jytole/train-and-go/website/images/chair_trip.jpg

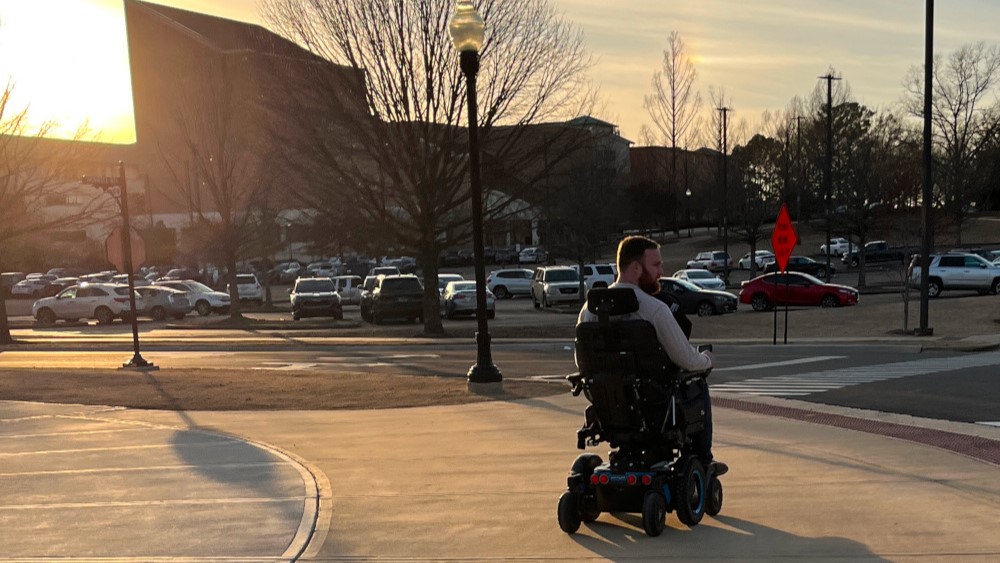
website/images/chair_trip.jpg
