jytole/train-and-go/website/images/brake_lights.jpg

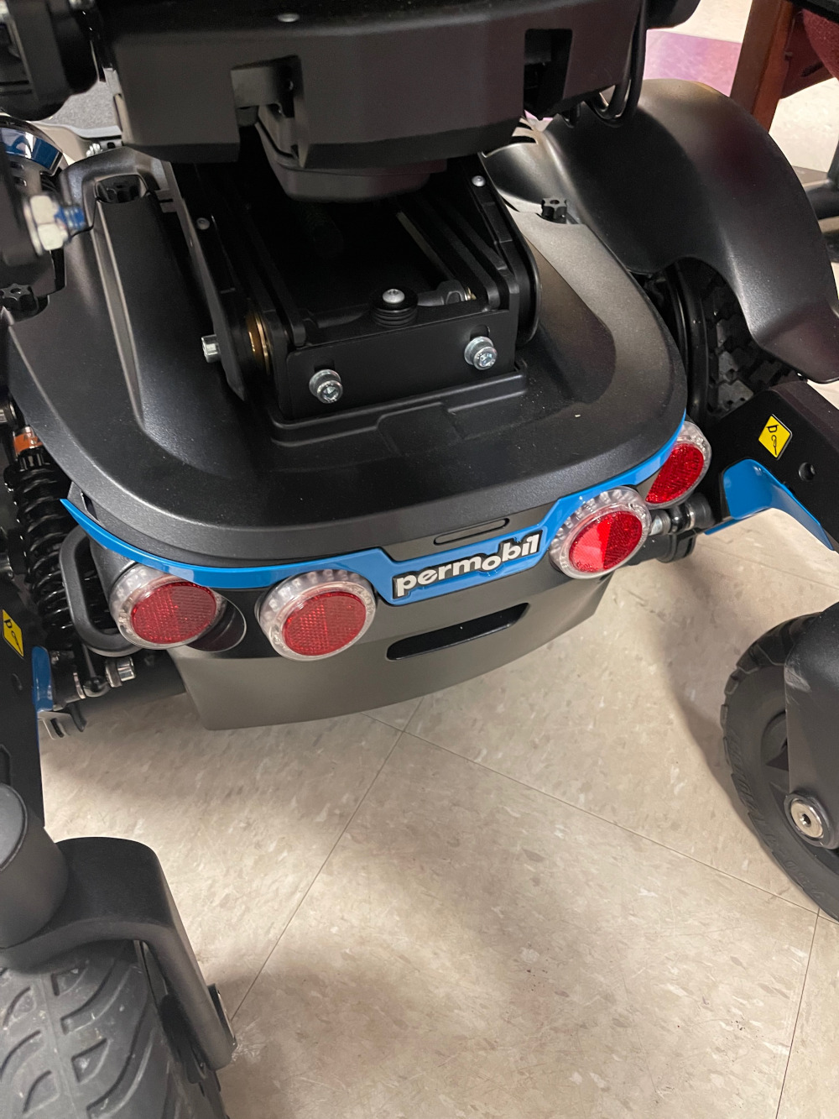
website/images/brake_lights.jpg
