jytole/train-and-go/website/deliverables/TrainandGo_Final_Presentation.pdf

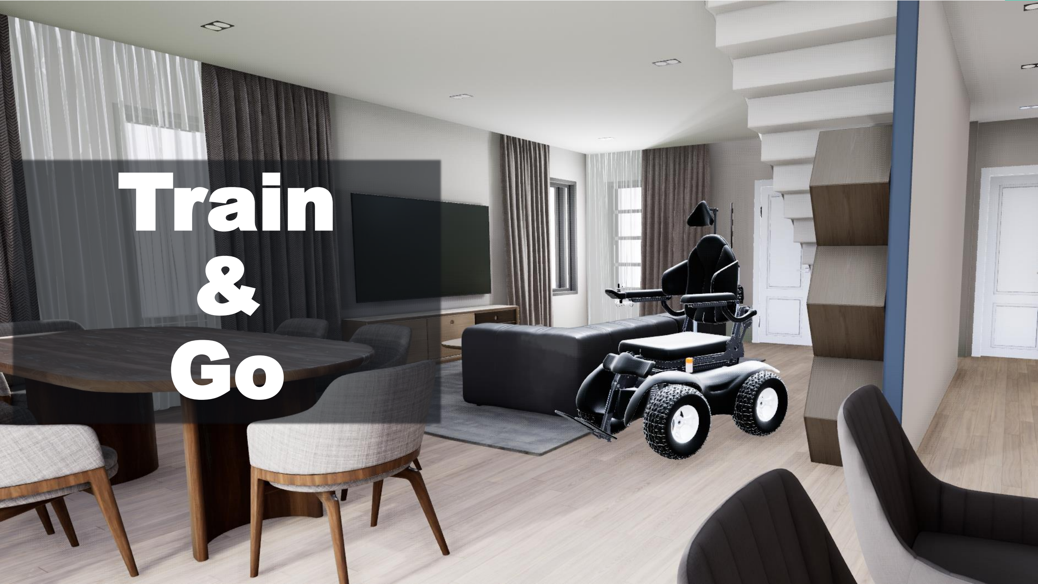
[picture p85: page 1]

# Train

&
Go

# TEAM MEMBERS

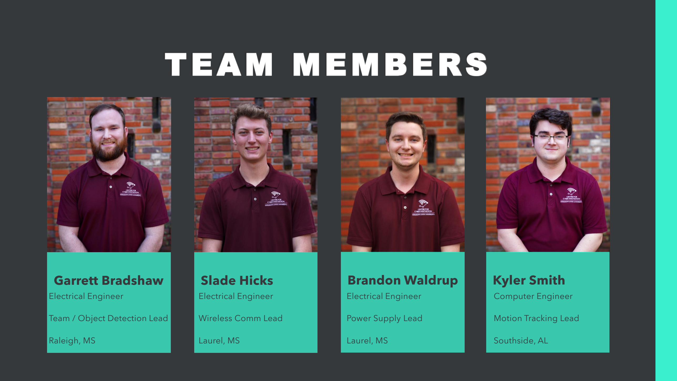
[picture p86: page 2]

## Garrett Bradshaw

Electrical Engineer

Team / Object Detection Lead

Raleigh, MS

## Slade Hicks

Electrical Engineer

Wireless Comm Lead

Laurel, MS

## Brandon Waldrup

Electrical Engineer

Power Supply Lead

Laurel, MS

## Kyler Smith

Computer Engineer

Motion Tracking Lead

Southside, AL

# INTERNAL ADVISOR

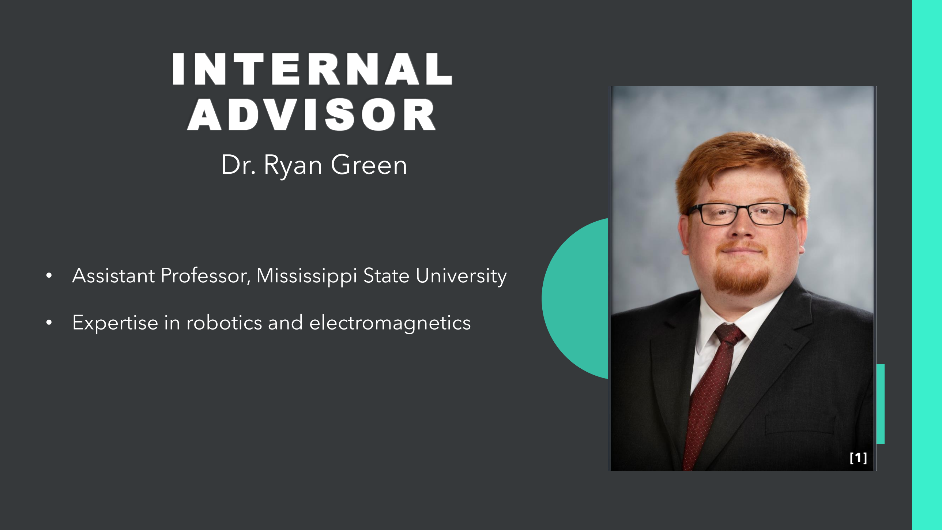
[picture p87: page 3]

# - Assistant Professor, Mississippi State University

# - Expertise in robotics and electromagnetics

# Dr. Ryan Green

[1]

# EXTERNAL ADVISOR

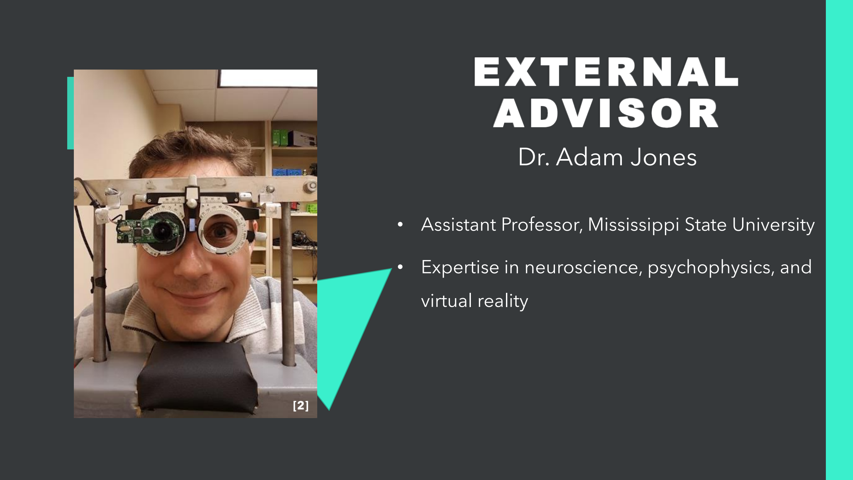
[picture p88: page 4]

# - Assistant Professor, Mississippi State University

# - Expertise in neuroscience, psychophysics, and

# virtual reality

# Dr. Adam Jones

[2]

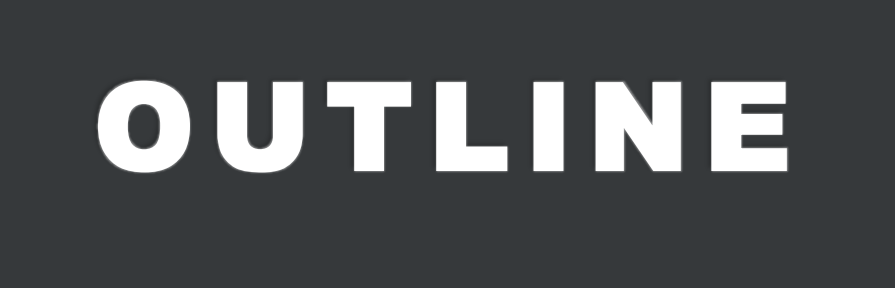
[picture p89: figure]
OUTLINE
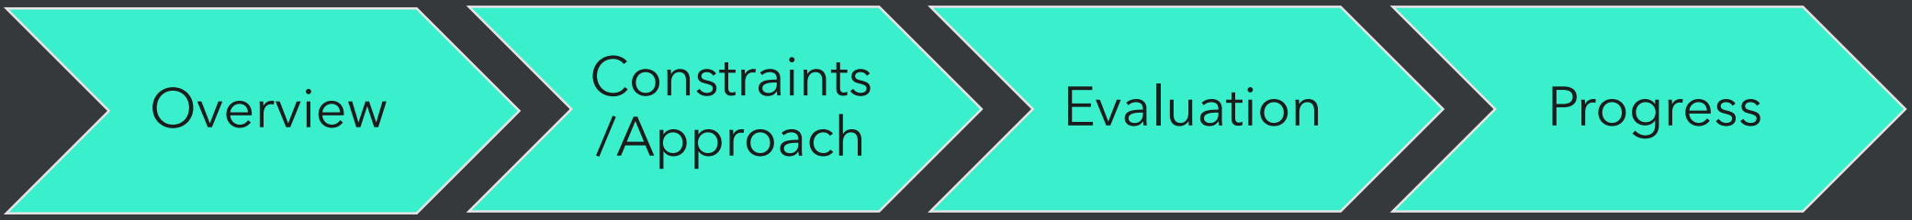
[picture p90: figure]
Overview; Constraints; /Approach; Evaluation; Progress
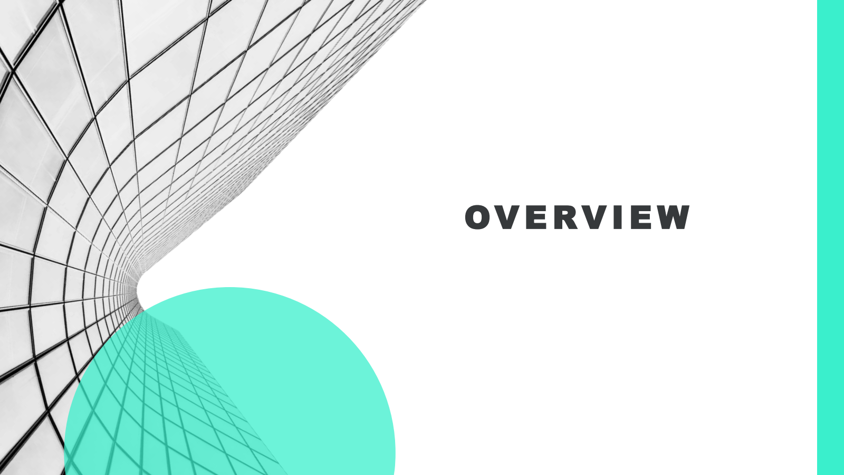
[picture p91: page 6]

# OVE RVI E W

# Problem

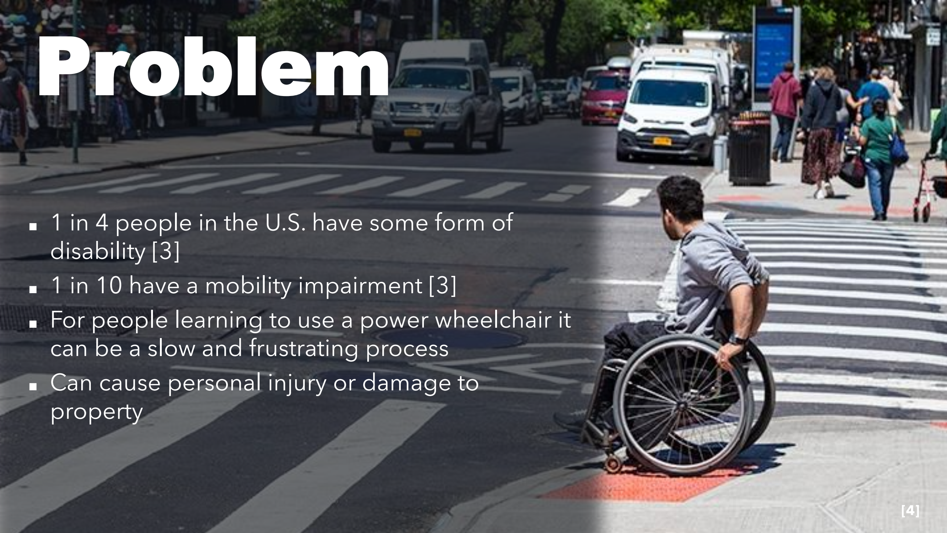
[picture p92: page 7]

[4]

# ∎ 1 in 4 people in the U.S. have some form of disability [3] ∎ 1 in 10 have a mobility impairment [3] ∎ For people learning to use a power wheelchair it can be a slow and frustrating process ∎ Can cause personal injury or damage to property

# Solution

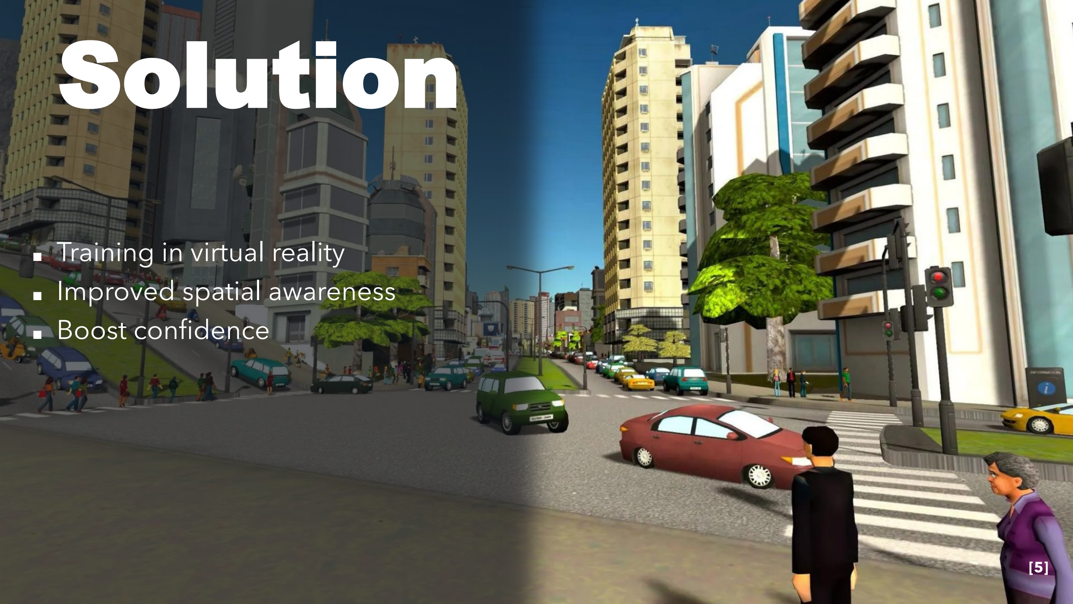
[picture p93: page 8]

8

# ∎ Training in virtual reality ∎ Improved spatial awareness ∎ Boost confidence

[5]

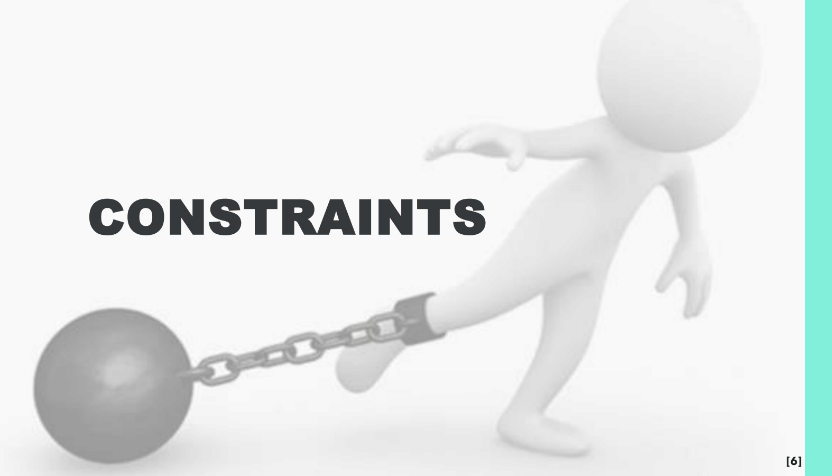
[picture p94: page 9]

# CONSTRAINTS

[6]

# TECHNICAL CONSTRAINTS

Name | Description
Wheelchair Speed | The system is attached to a wheelchair moving no faster than five miles per hour [7].
Detection Distance | The system detects objects within a radius of no more than 2.2 meters.
Feedback Latency | This system’s latency for sending feedback to the user in response to an object is no more than 250 milliseconds.
Sensor Accuracy | The system’s false detection rate is less than 16 percent.
Wireless Range | The system can connect wirelessly to a Quest VR headset within 2.31 meters.
Wireless Latency | The wireless latency is less than 250 milliseconds.

# PRACTICAL CONSTRAINTS

Type | Name | Description
Sustainability | Reliability | Train and Go is designed to operate for at least five years without component failure.
Sustainability | Sensor Maintenance | Sensor connections are placed strategically to allow simple maintenance or replacement.
Usability | Product Versatility | Train and Go offers a flexible packaging system to attach to a variety of wheelchair designs and does not inhibit existing chair functionality.
Safety | Collision Detection | Train and Go provides the user with feedback to minimize the risk of collisions with obstacles.
Functionality | VR Communication | Train and Go communicates with a Quest VR headset.

# ENGINEERING STANDARDS

Specific Standard | Standard Document | Specification / Application
IP-44 | International Electrotechnical Commission Standard 60529 | The system is protected from solid particles that are over 1 millimeter in size and from splashes of water [8].
Bluetooth | Institute of Electrical and Electronics Engineers 802-15.1 | The system adheres to IEEE Bluetooth standards [9].
Protection Against Electric Shock | International Electrotechnical Commission Standard 62368 | The electrical components of the system are isolated from the user to prevent electric shock [10].
Wheelchair Accessory | FDA 21 Code of Federal Regulations § 890.3910 | Train and Go satisfies the FDA standards for a wheelchair accessory [11].

# FUNCTIONAL DIAGRAM


# HARDWARE

# ASSEMBLY DIAGRAM


[12]

# HARDWARE

Part Type | Part
Ultrasonic Sensor [13] | HCSR04
Rumble Motor [14] | Tatoko
DC-DC Converter [15] | Yipin Hexha
VR Headset [16] | Meta Quest Pro
IMU [17] | ISM330DHCX
Detection Microcontroller [18] | Elegoo Mega
Orientation Microcontroller [19] | ESP32
Battery [20] | Zeee 2S Lipo
Voltage Rail [21] | Evemodel

# SOFTWARE

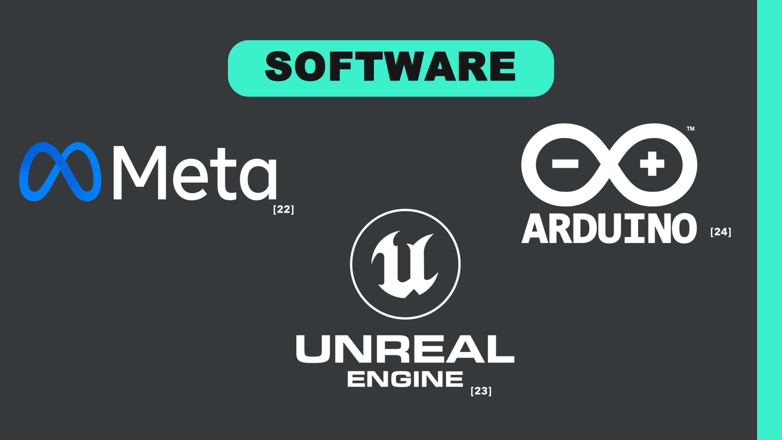
[picture p95: page 17]

[22]

[23]

[24]

# OLD ORIENTATION PROCESSING

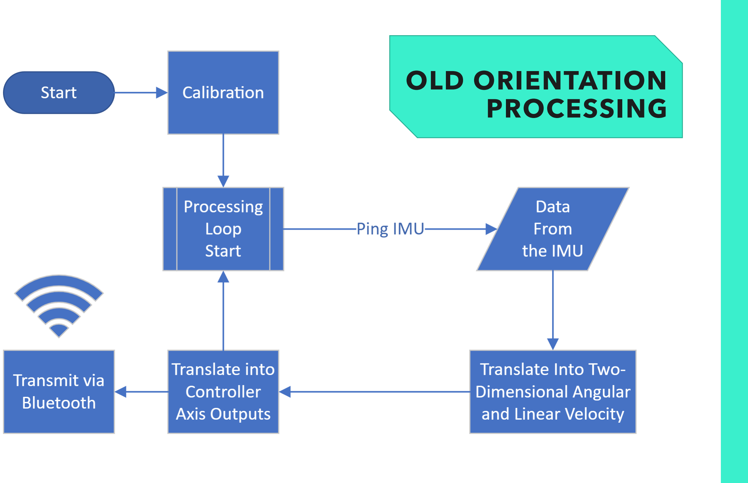
[picture p96: page 18]
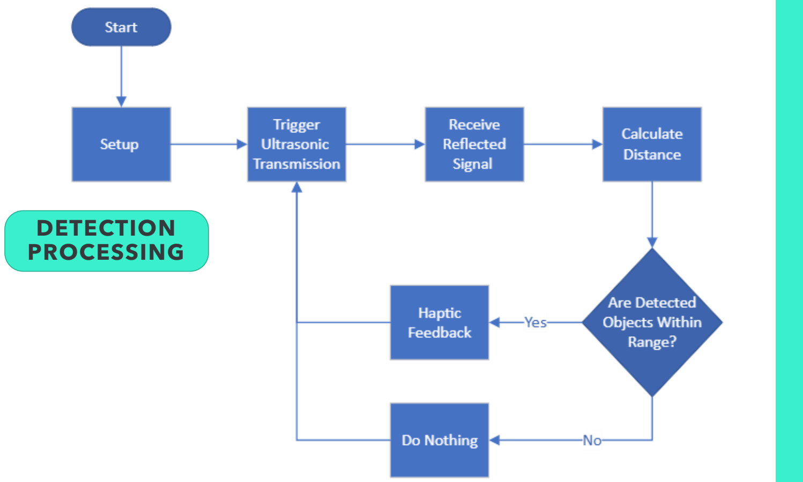
[picture p97: page 19]

# DETECTION PROCESSING

# VR ENVIRONMENT

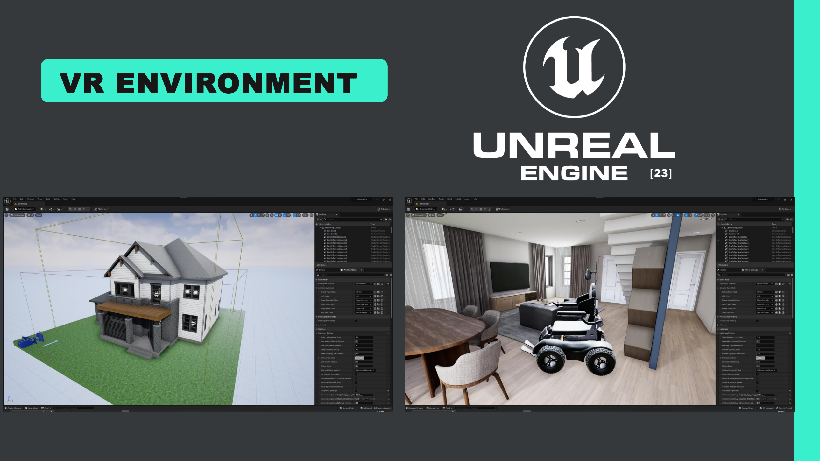
[picture p98: page 20]

[23]

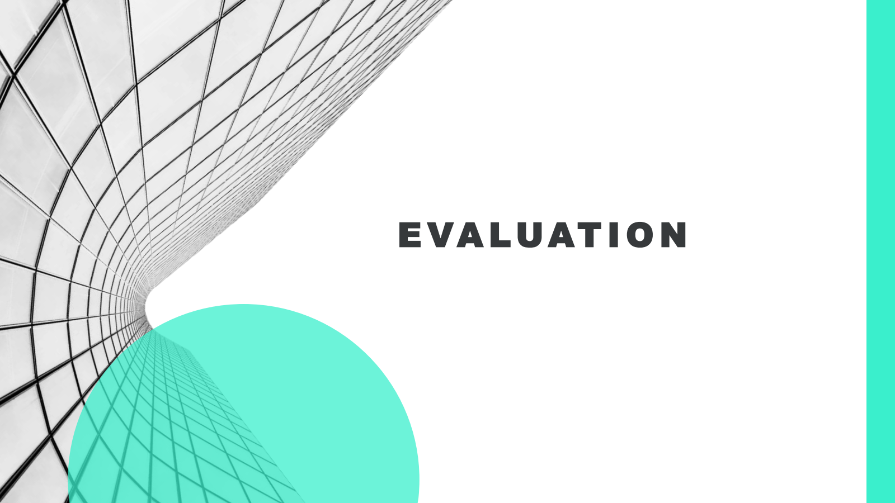
[picture p99: page 21]

# E VALUAT I ON

# BLUETOOTH CONNECTION

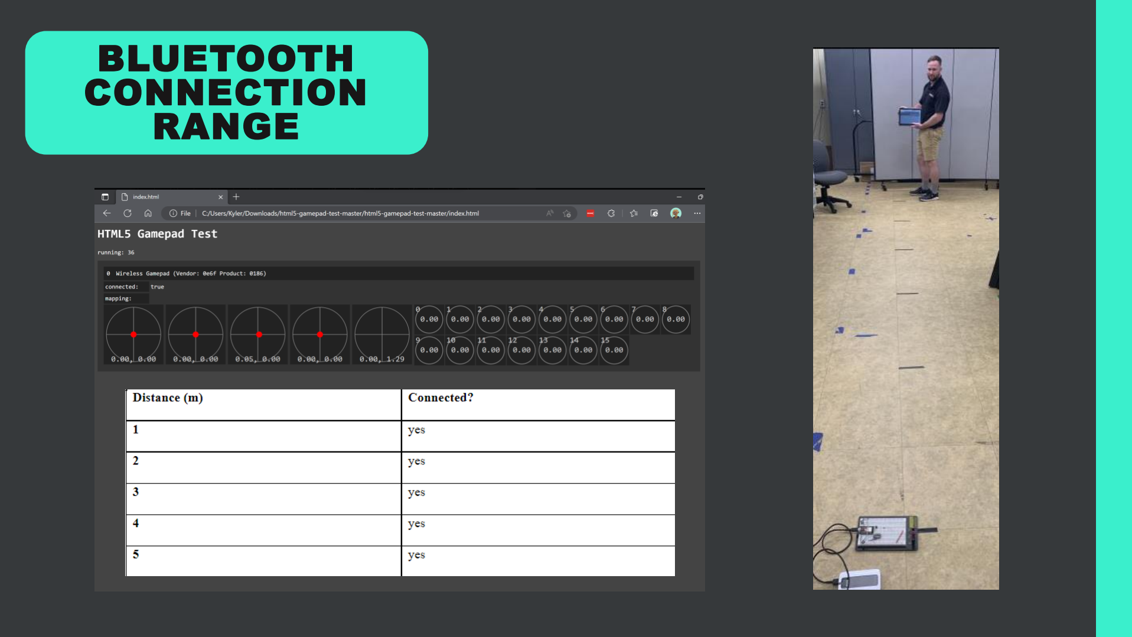
[picture p100: page 22]

# RANGE

# ULTRASONIC

# SENSOR

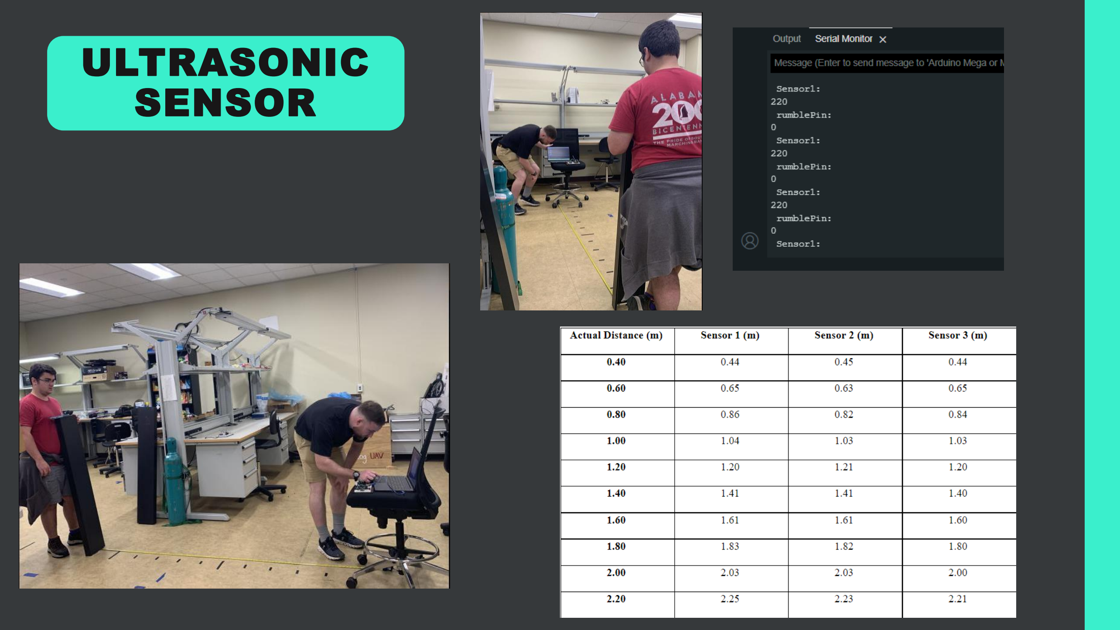
[picture p101: page 23]

# SENSOR

# ACCURACY AND

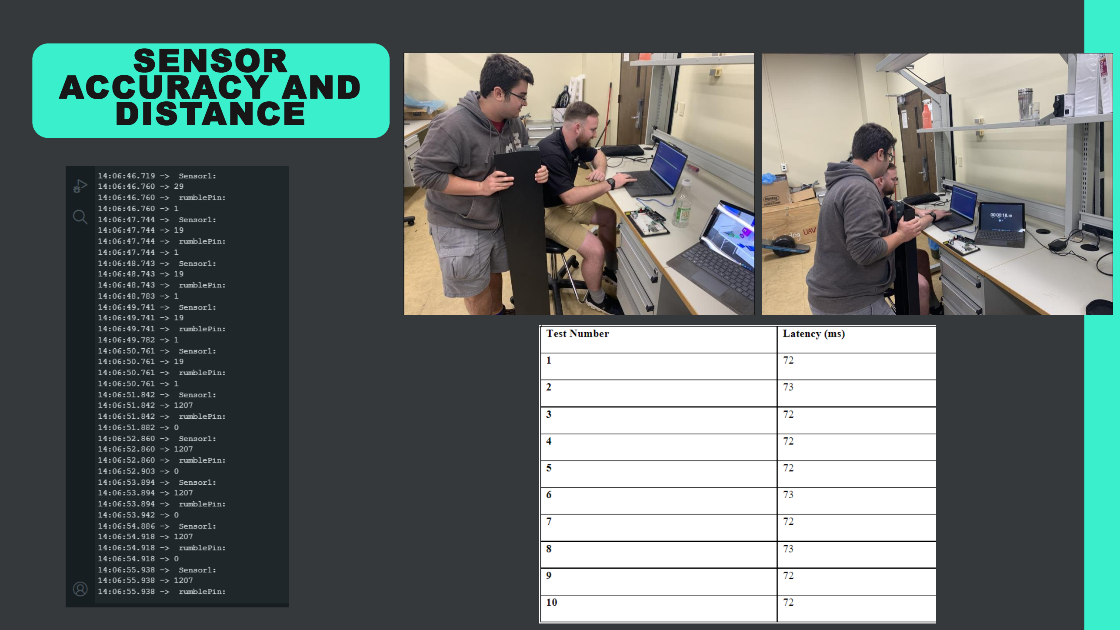
[picture p102: page 24]

# DISTANCE

# IP44 WATER RESISTANCE TEST

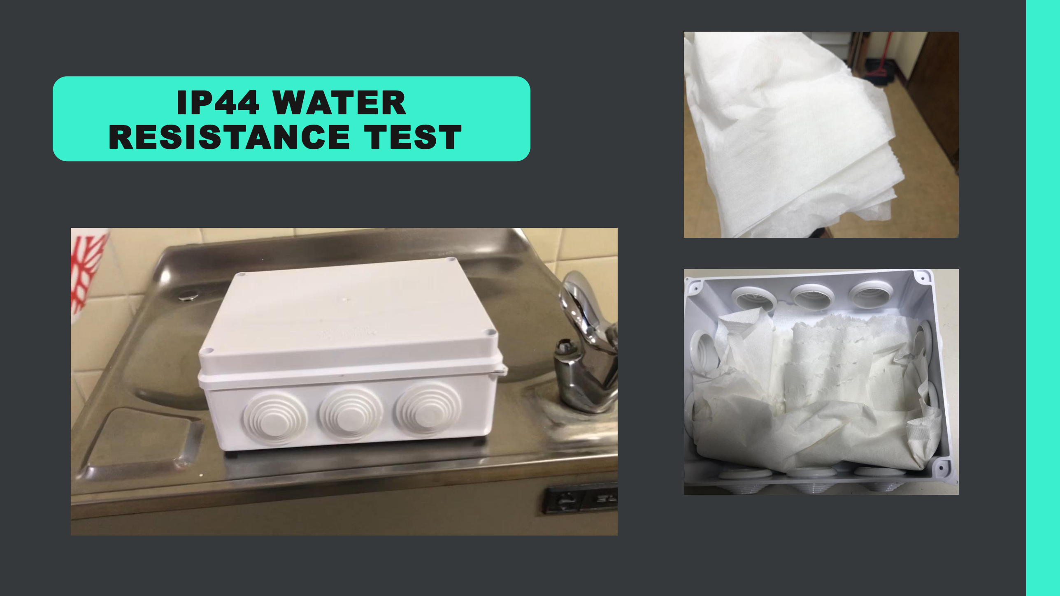
[picture p103: page 25]

# IMU ACCURACY

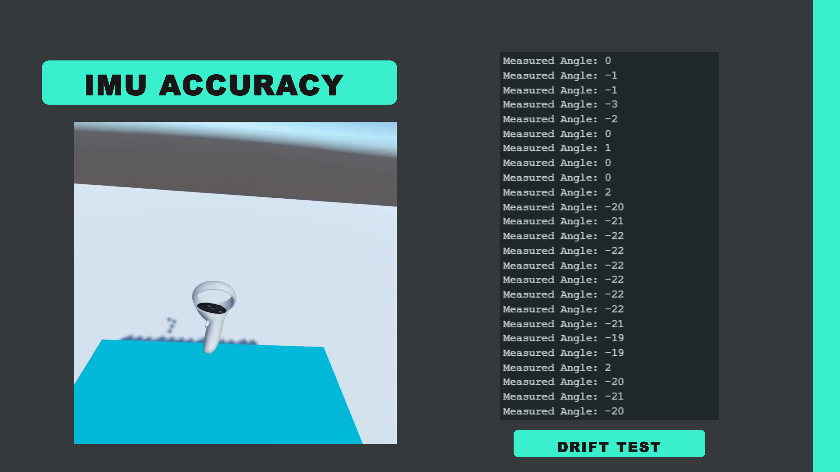
[picture p104: page 26]

### DRIFT TEST

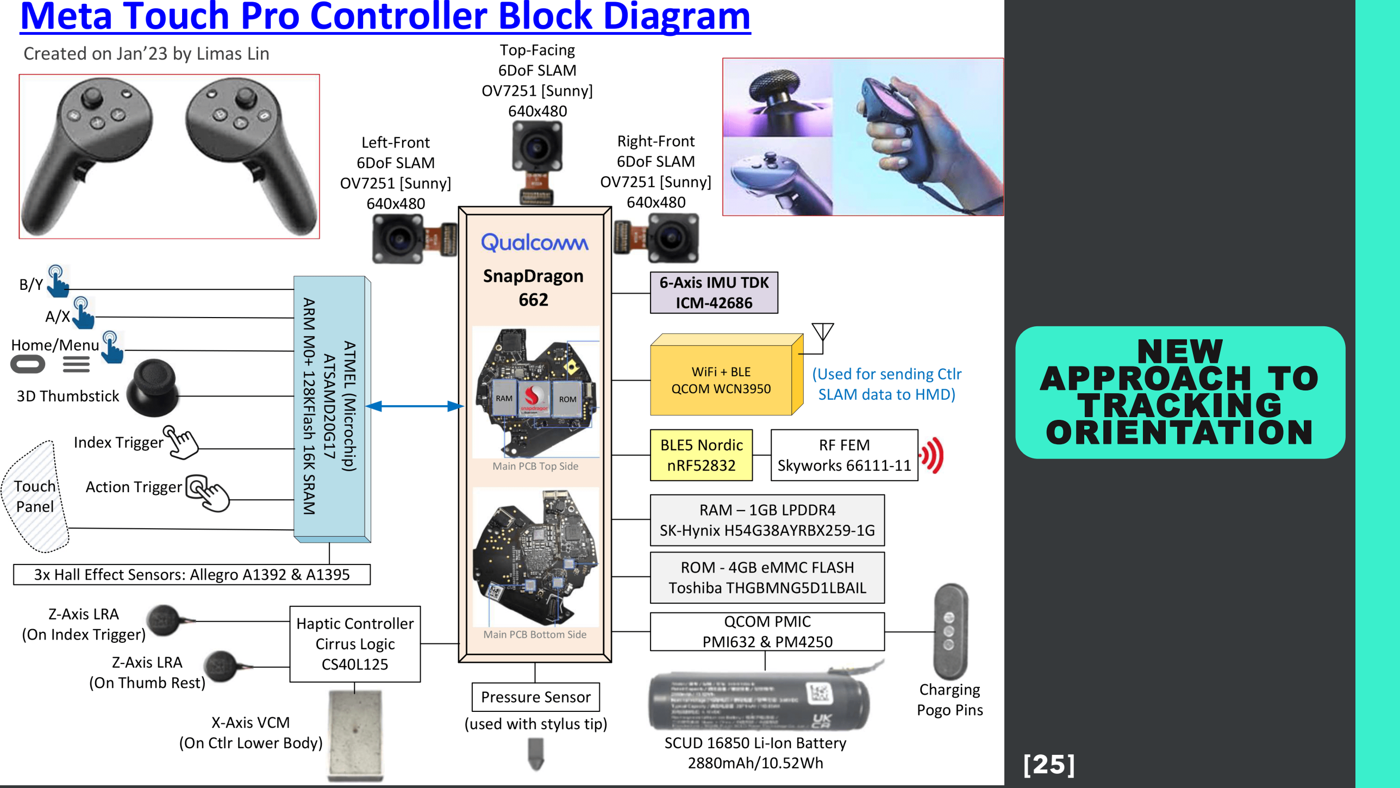
[picture p105: page 27]

# NEW APPROACH TO TRACKING ORIENTATION

[25]

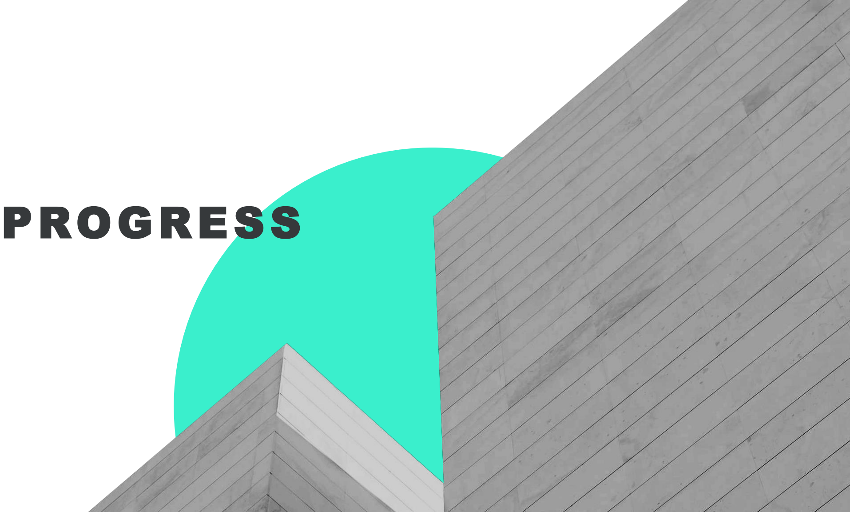
[picture p106: page 28]

# PROGRESS

# TIMELINE

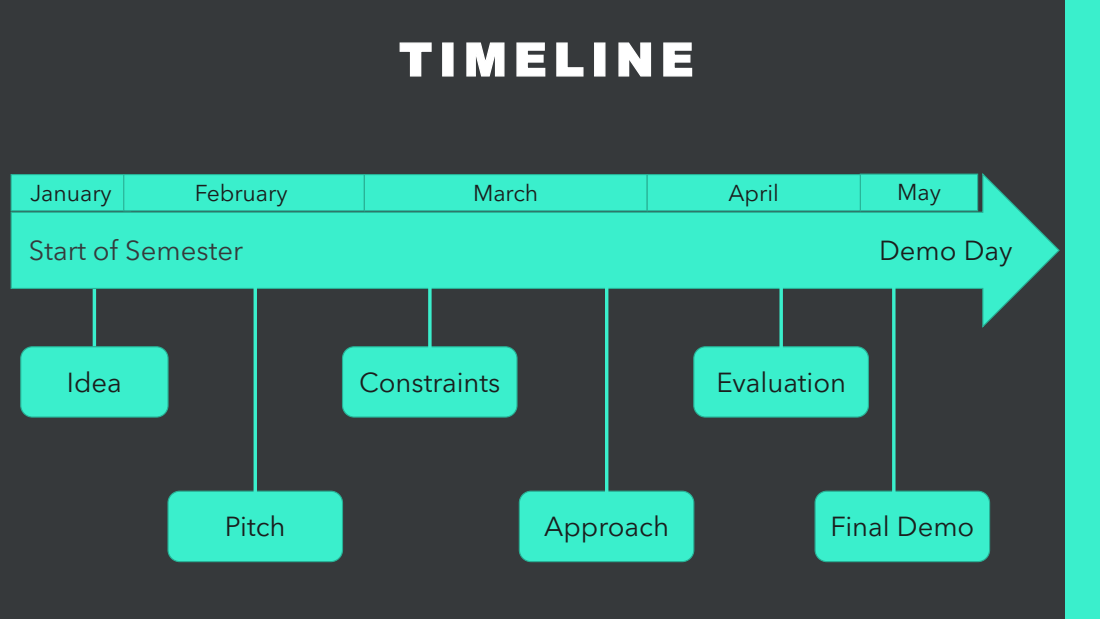
[picture p107: page 29]
Start of Semester; Demo Day; Idea; Pitch; Constraints; Approach; Evaluation; Final Demo; January; February; March; April; May

# ASSEMBLY

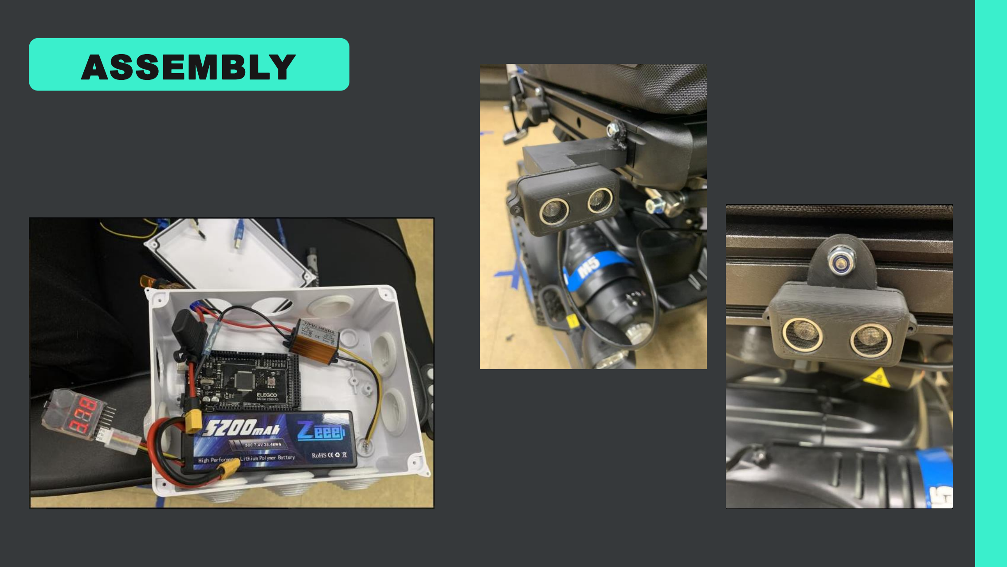
[picture p108: page 30]

# VR ENVIRONMENT

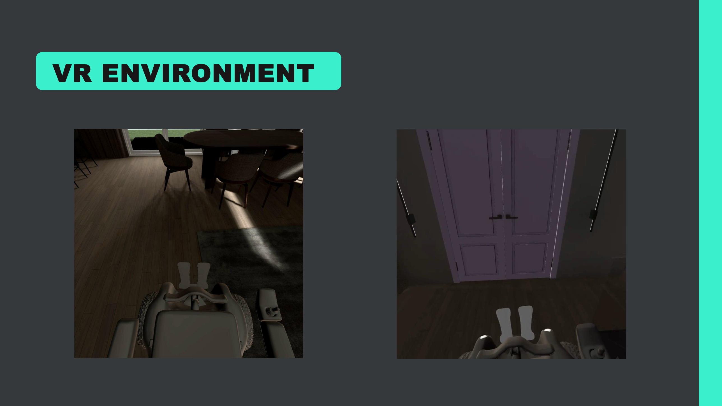
[picture p109: page 31]

# VR ENVIRONMENT

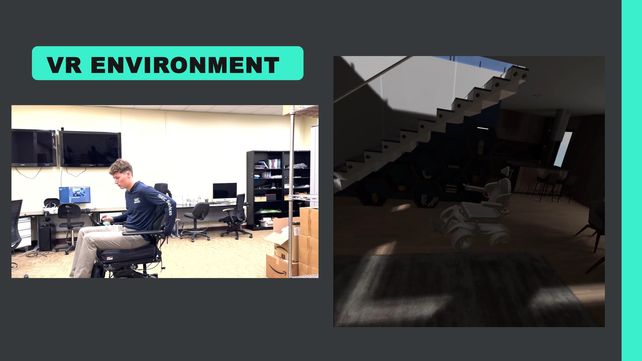
[picture p110: page 32]

# What is left :

# - Finish testing any remaining subsystems checks

# - Finalize construction of the prototype for demo day

# Future improvements:

# - Develop a PCB for sensor connections inside the enclosure

# - Curate additional VR environments

# - Optimize obstacle detection and haptic feedback to be directional

# FINAL TO DO LIST AND IMPROVEMENTS FOR REVISION: 02

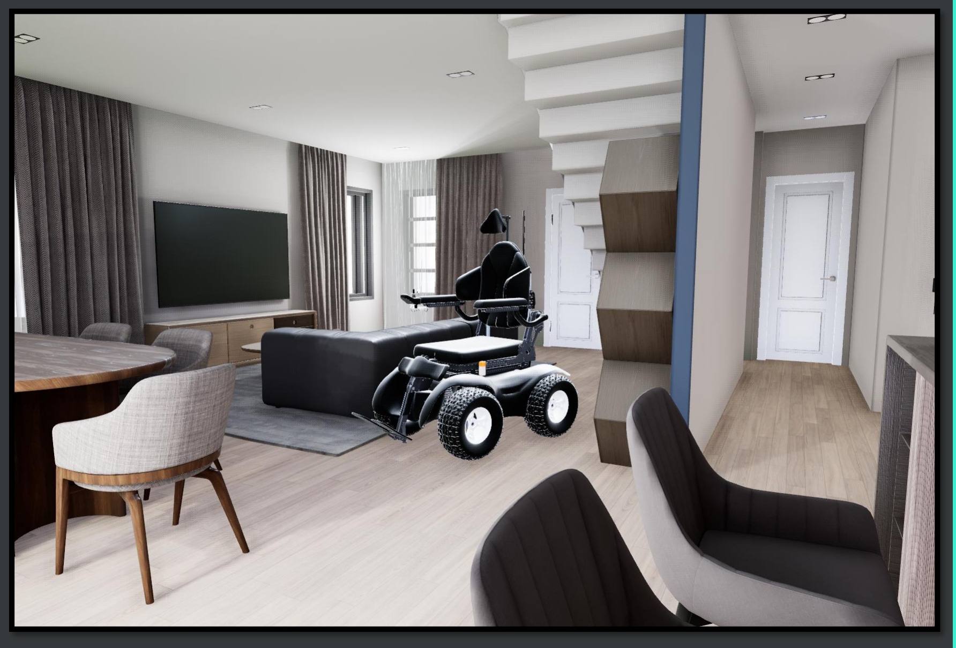
[picture p111: figure]

# - Train and Go provides an

# enhanced VR wheelchair training

# experience

# - Train and Go ensures user safety

# during that training experience

# - Train and Go empowers people

# with disabilities

# CONCLUSION

# S O U R C E S

[1] Mississippi State University, "Faculty," msstate.edu. https://www.ece.msstate.edu/people/faculty/ (Accessed: Mar. 25, 2023).
[2] Mississippi State University, "Faculty," msstate.edu. https://www.cse.msstate.edu/people/faculty/ (Accessed: Mar. 25, 2023).
[3] Centers for Disease Control and Prevention, "Disability impacts all of us," Cdc.gov. https://www.cdc.gov/ncbddd/disabilityandhealth/infographicdisability-impacts-all.html (Accessed: Jan. 31, 2023).
[4] United Spinal Association, "NYC sidewalks finally complying with ADA," unitedspinal.org. https://unitedspinal.org/nyc-sidewalks-finally-complyingwith-ada/ (Accessed Jan. 31, 2023).
[5] L. Faria, "Review-cities VR," waytoomany.games. https://waytoomany.games/?s=cities+vr (Accessed: Jan. 31, 2023).
[6] Disher, "Product constraints: The catalyst of great design," disher.com. https://www.disher.com/blog/product-constraints-can-catalyst-greatdesign/ (Accessed: Mar. 25, 2023).
[7] A. Smith, “How fast do electric wheelchairs go?” Mobility Medical Supply. https://mobilitymedicalsupply.com/how-fast-do-electric-wheelchairs-go/. (Accessed: Feb. 16, 2023).
[8] Degrees of protection provided by enclosures (IP Code), International Electrotechnical Commission 60529, International Electrotechnical Commission, 2019. https://www.iec.ch/ip-ratings. (Accessed: Feb. 22, 2023).
[9] Medium access control and physical layers, Institute of Electrical and Electronics Engineers 802.15.1, Institute of Electrical and Electronics Engineers, 2005. https://standards.ieee.org/ieee/802.15.1/3513/. (Accessed: Feb. 22, 2023).
[10] Audio/video, information, and communication technology equipment - Part 1: Safety requirements, International Electrotechnical Commission 62368, International Electrotechnical Commission, 2018. https://webstore.iec.ch/publication/63964. (Accessed: Feb. 22, 2023).
[11] Wheelchair accessory, Code of Federal Regulations Title 21 Section 890.3910, FDA, 2001. https://www.accessdata.fda.gov/scripts/cdrh/cfdocs/cfcfr/cfrsearch.cfm?fr=890.3910. (Accessed: Feb. 22, 2023).
[12] "Permobil M5 corpus power wheelchair," medicaleshop.com. https://www.medicaleshop.com/permobil-m5-corpus-power-wheelchair.html (Accessed: Mar. 25, 2023).
[13] “HC-SR04 Ultrasonic Distance Sensor,” amazon.com. https://www.amazon.com/ACEIRMC-HC-SR04-Ultrasonic-Distance-ElecRightt/dp/B09J4BN46F/r (Accessed: Mar. 03, 2023).

# S O U R C E S

[14] “Tatoko Rumble Motor,” amazon.com. https://www.amazon.com/tatoko-vibration-Waterproof-8000-16000RPM-toothbrush/dp/B07KYLZC1S/(Accessed: Mar. 03, 2023).
[15] “YIPIN HEXHA Voltage Converter,” amazon.com. https://www.amazon.com/dp/B0BS5ZCP1N (Accessed: Mar. 03, 2023 ).
[16] “Meta Quest Pro,” amazon.com. https://www.amazon.com/Meta-Quest-Pro-Oculus/dp/B09Z7KGTVW/ (Accessed: Mar. 03, 2023).
[17] “Adafruit ISM330DHCX – 6 DoF IMU,” adafruit.com. https://www.adafruit.com/product/4502 (Accessed: Mar. 03, 2023).
[18] “Elegoo Mega Microcontroller,” amazon.com. https://www.amazon.com/ELEGOO-ATmega2560-ATMEGA16U2-Arduino-Compliant/dp/B01H4ZDYCE/ (Accessed: Mar. 03, 2023).
[19] “ESP32 datasheet,” adafruit.com. https://cdn-shop.adafruit.com/product-files/3269/esp32_datasheet_en_0.pdf (Accessed: Mar. 03, 2023).
[20] “Zeee 2S Lipo Battery,” amazon.com. https://www.amazon.com/dp/B092CZGW2P (Accessed: Mar. 03, 2023).
[21] “Evemodel Power Rail,” amazon.com. https://www.amazon.com/PCB007-Position-Distribution-Outputs-Voltage/dp/B07DW2C4ZB (Accessed: Mar. 03, 2023).
[22] "File:Meta Platforms Inc. logo.svg," wikimedia.org. https://commons.wikimedia.org/wiki/File:Meta_Platforms_Inc._logo.svg (Accessed: Mar. 25, 2023).
[23] "Unreal engine branding," unrealengine.com. https://www.unrealengine.com/en-US/branding (Accessed: Mar. 25, 2023).
[24] "Arduino - home," arduino.cc. https://www.arduino.cc/ (Accessed: Mar. 25, 2023).

[25]”Meta Quest Pro Controller”, kguttag.com https://kguttag.com/2023/03/15/meta-quest-pro-part-2-block-diagrams-teardown-of-headset-andcontroller/ (Accessed: April 26, 2023)
