jytole/train-and-go/website/images/brandon_waldrup.jpg

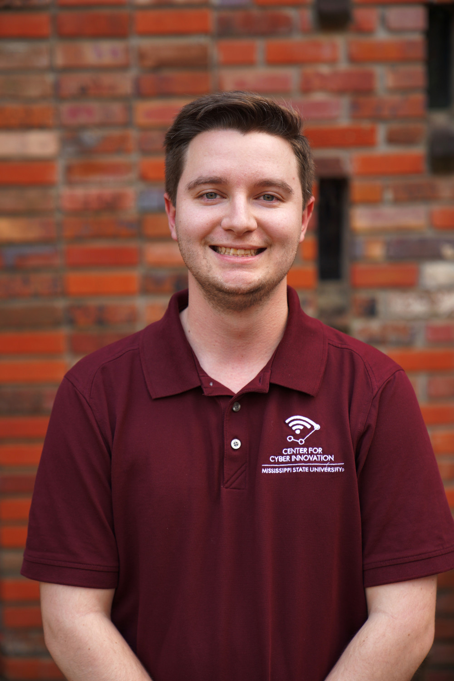
website/images/brandon_waldrup.jpg
