jytole/train-and-go/website/images/garrett_bradshaw.jpg

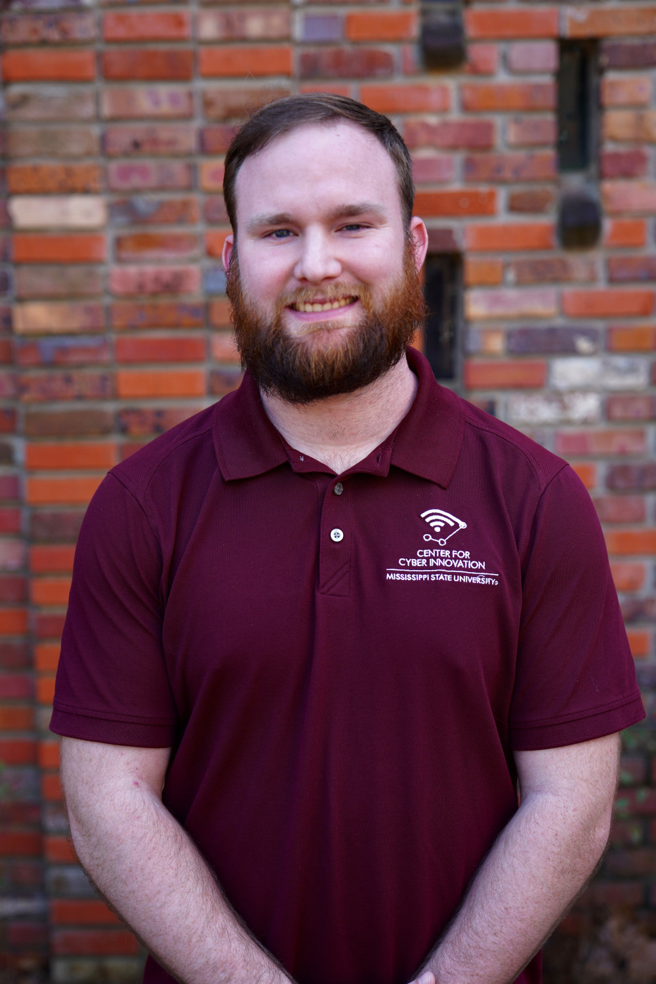
website/images/garrett_bradshaw.jpg
