jytole/train-and-go/website/images/joystick.jpg

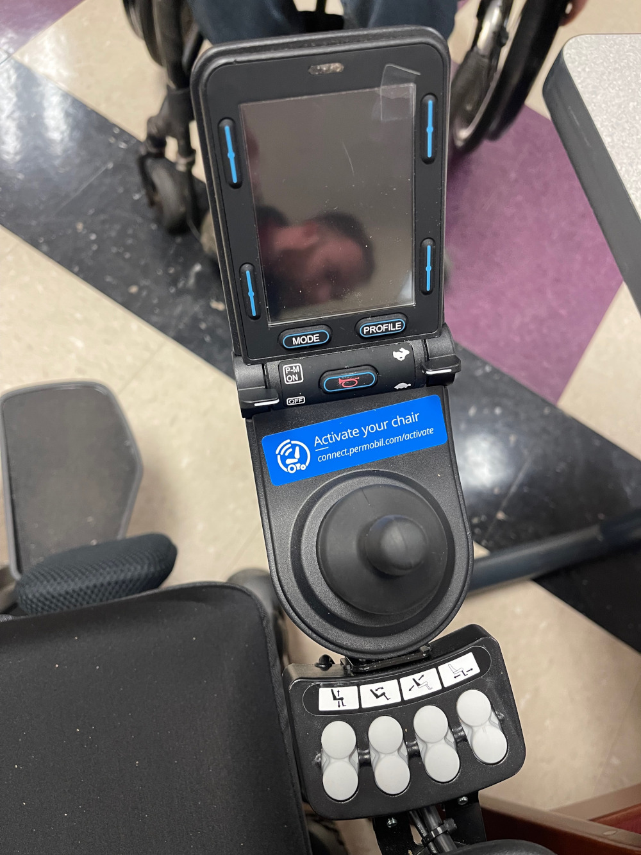
website/images/joystick.jpg
