jytole/train-and-go/website/images/kyler_smith.jpg

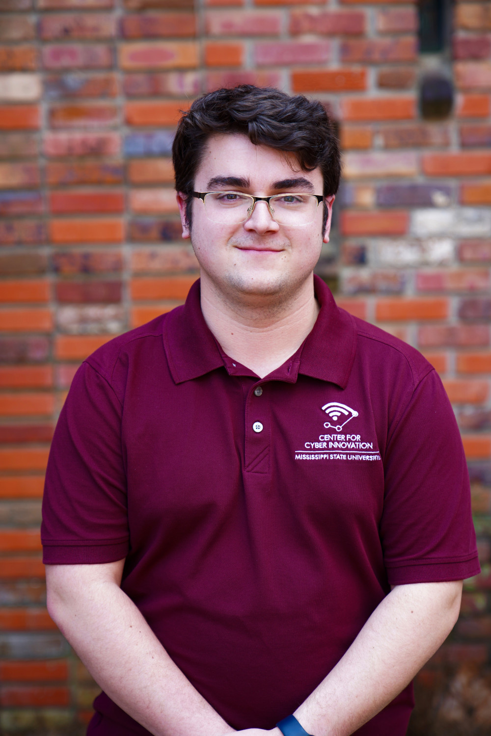
website/images/kyler_smith.jpg
