jytole/train-and-go/website/images/slade_hicks.jpg

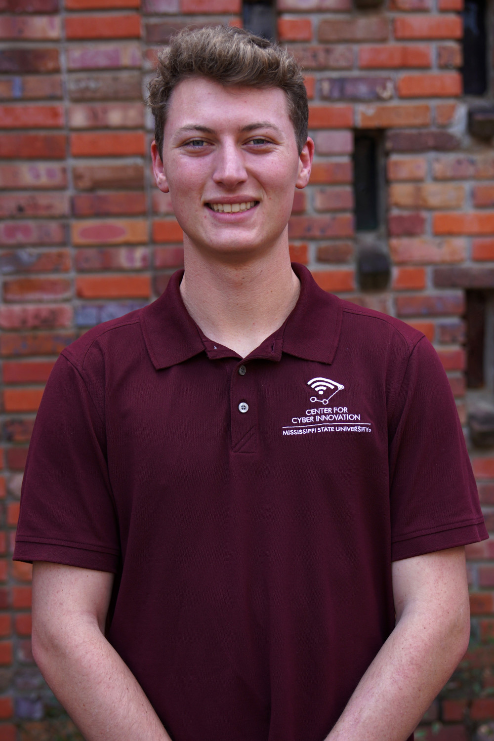
website/images/slade_hicks.jpg
