jytole/train-and-go/website/images/UnrealImage1.png

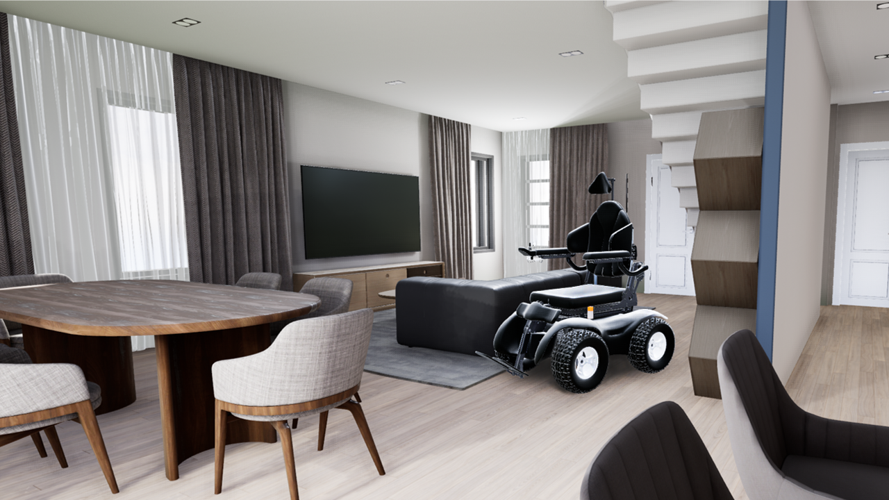
website/images/UnrealImage1.png
